Lazztech/TEG/cad/exports/wedge_enclosure.png

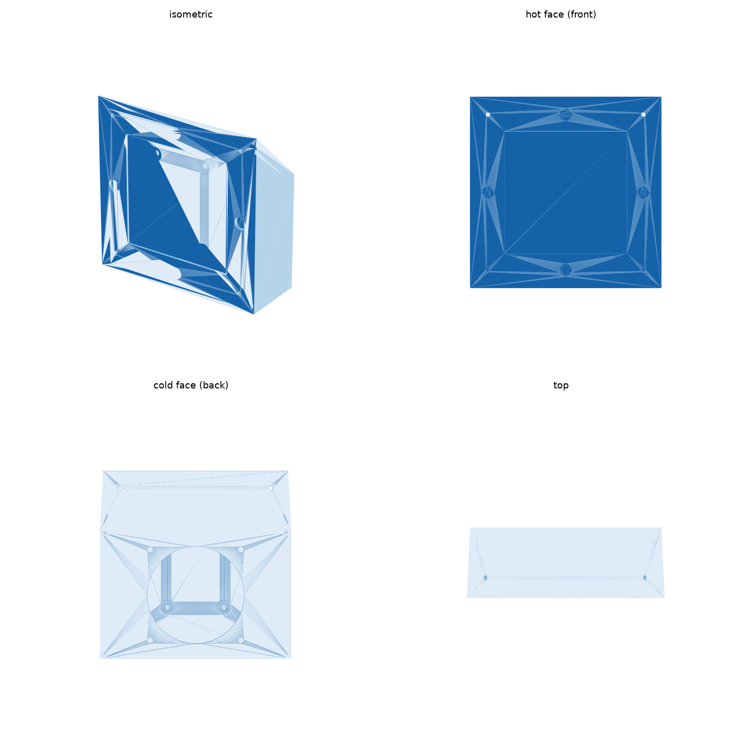
cad/exports/wedge_enclosure.png
