Lazztech/TEG/cad/exports/wedge_enclosure.step

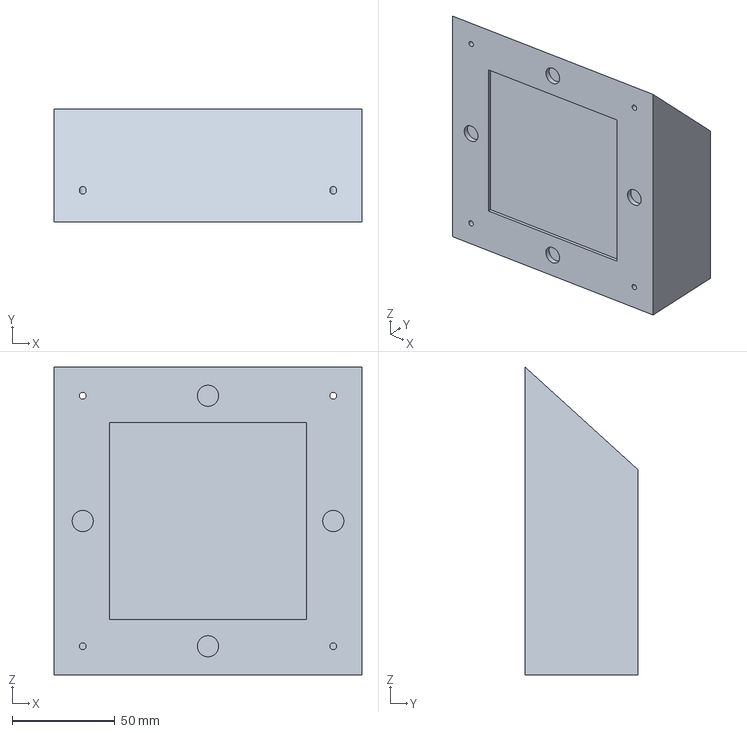
[picture p2: CAD file, 2026-10-20]
cad/exports/wedge_enclosure.step
150.0 x 55.0 x 150.0 mm
