Lazztech/TEG/(list of files, cad)

Other CAD files:
cad/exports/wedge_enclosure.stl
