Lazztech/TEG/hardware/TEG.kicad_pcb

## KiCad design hardware/TEG.kicad_pcb (2026-10-11)

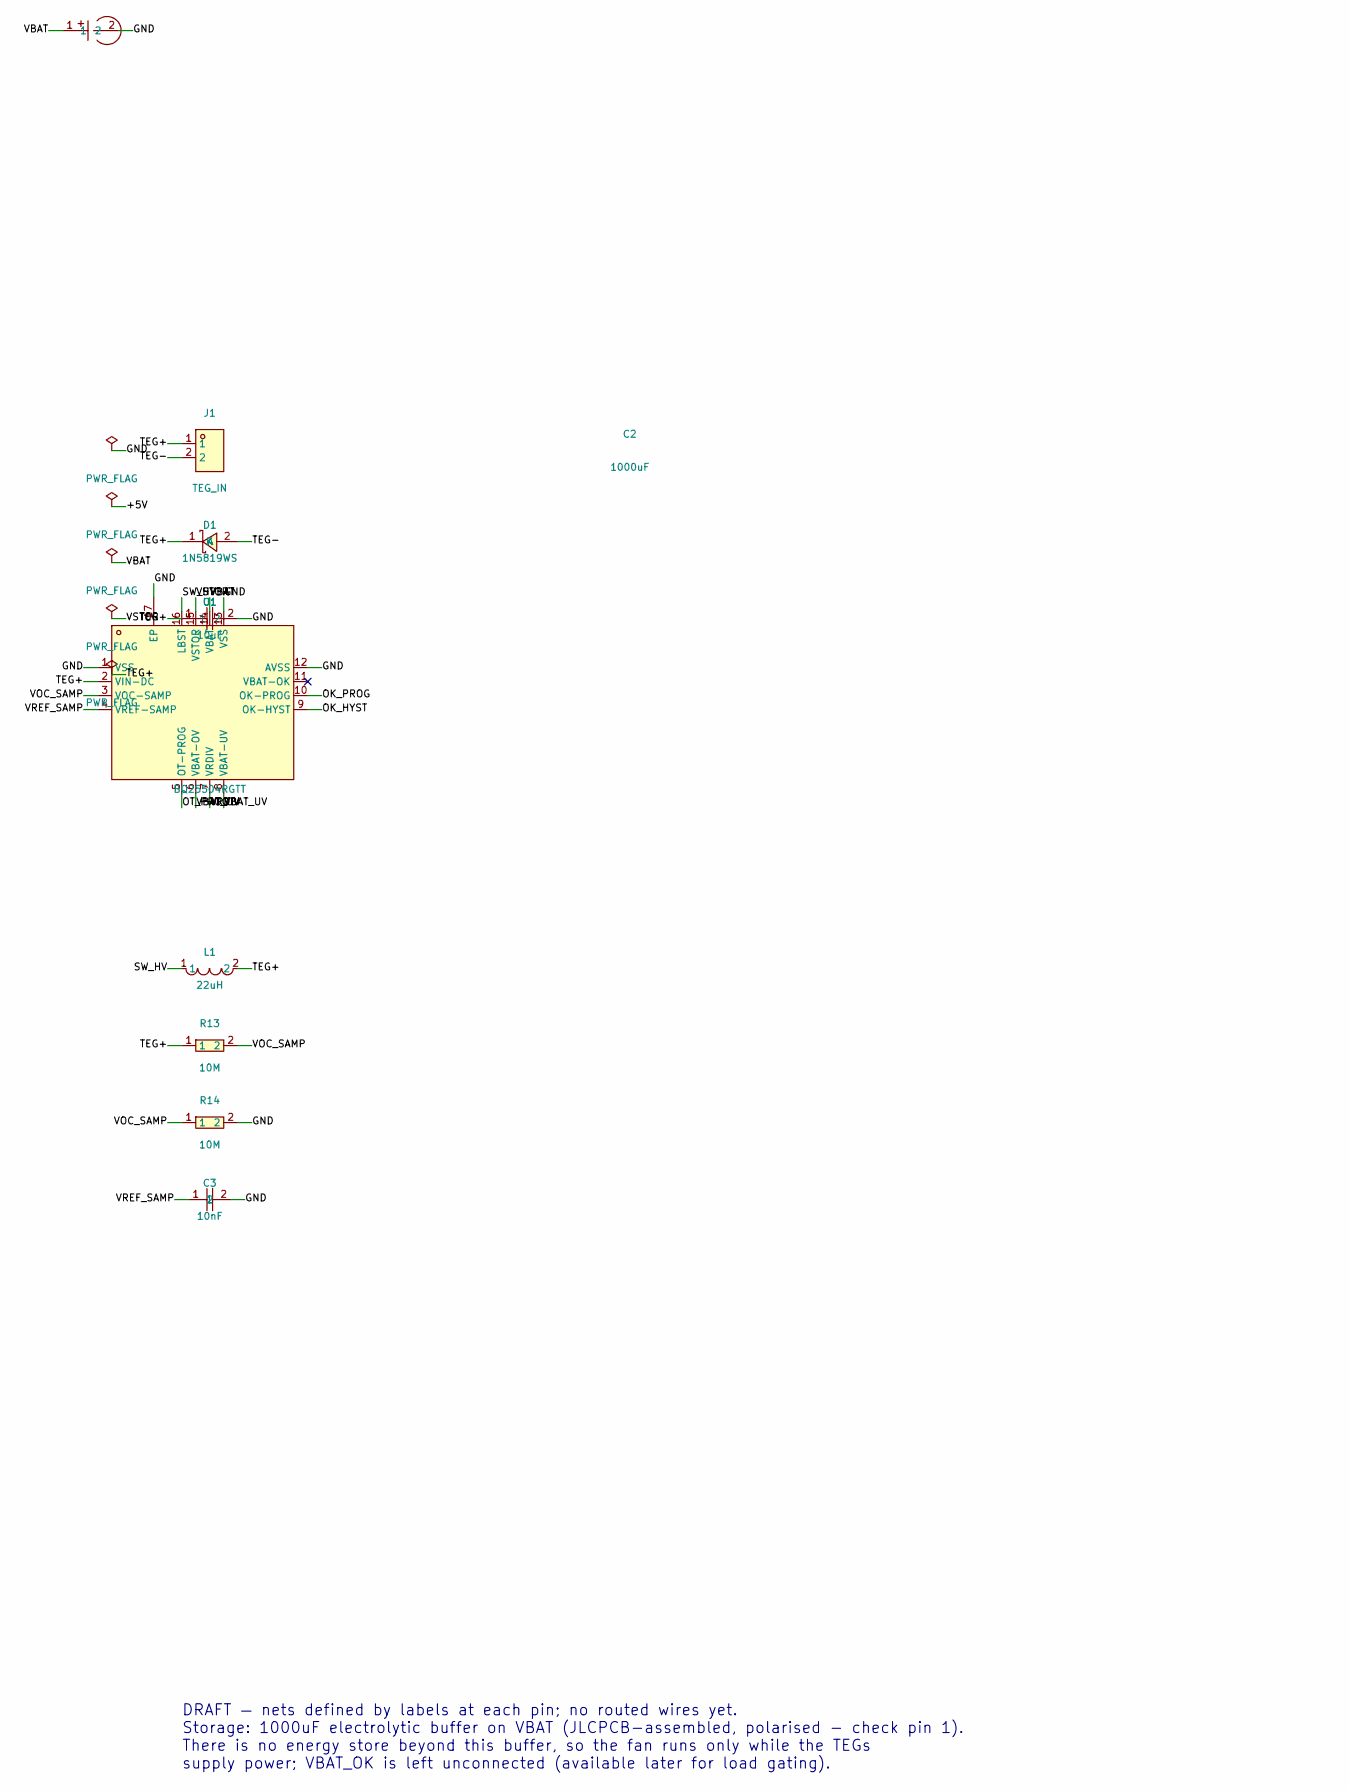
[picture p3: schematic TEG.kicad_sch, TEG Thermal Harvester — Power Conditioning, part in row 1, column 1]

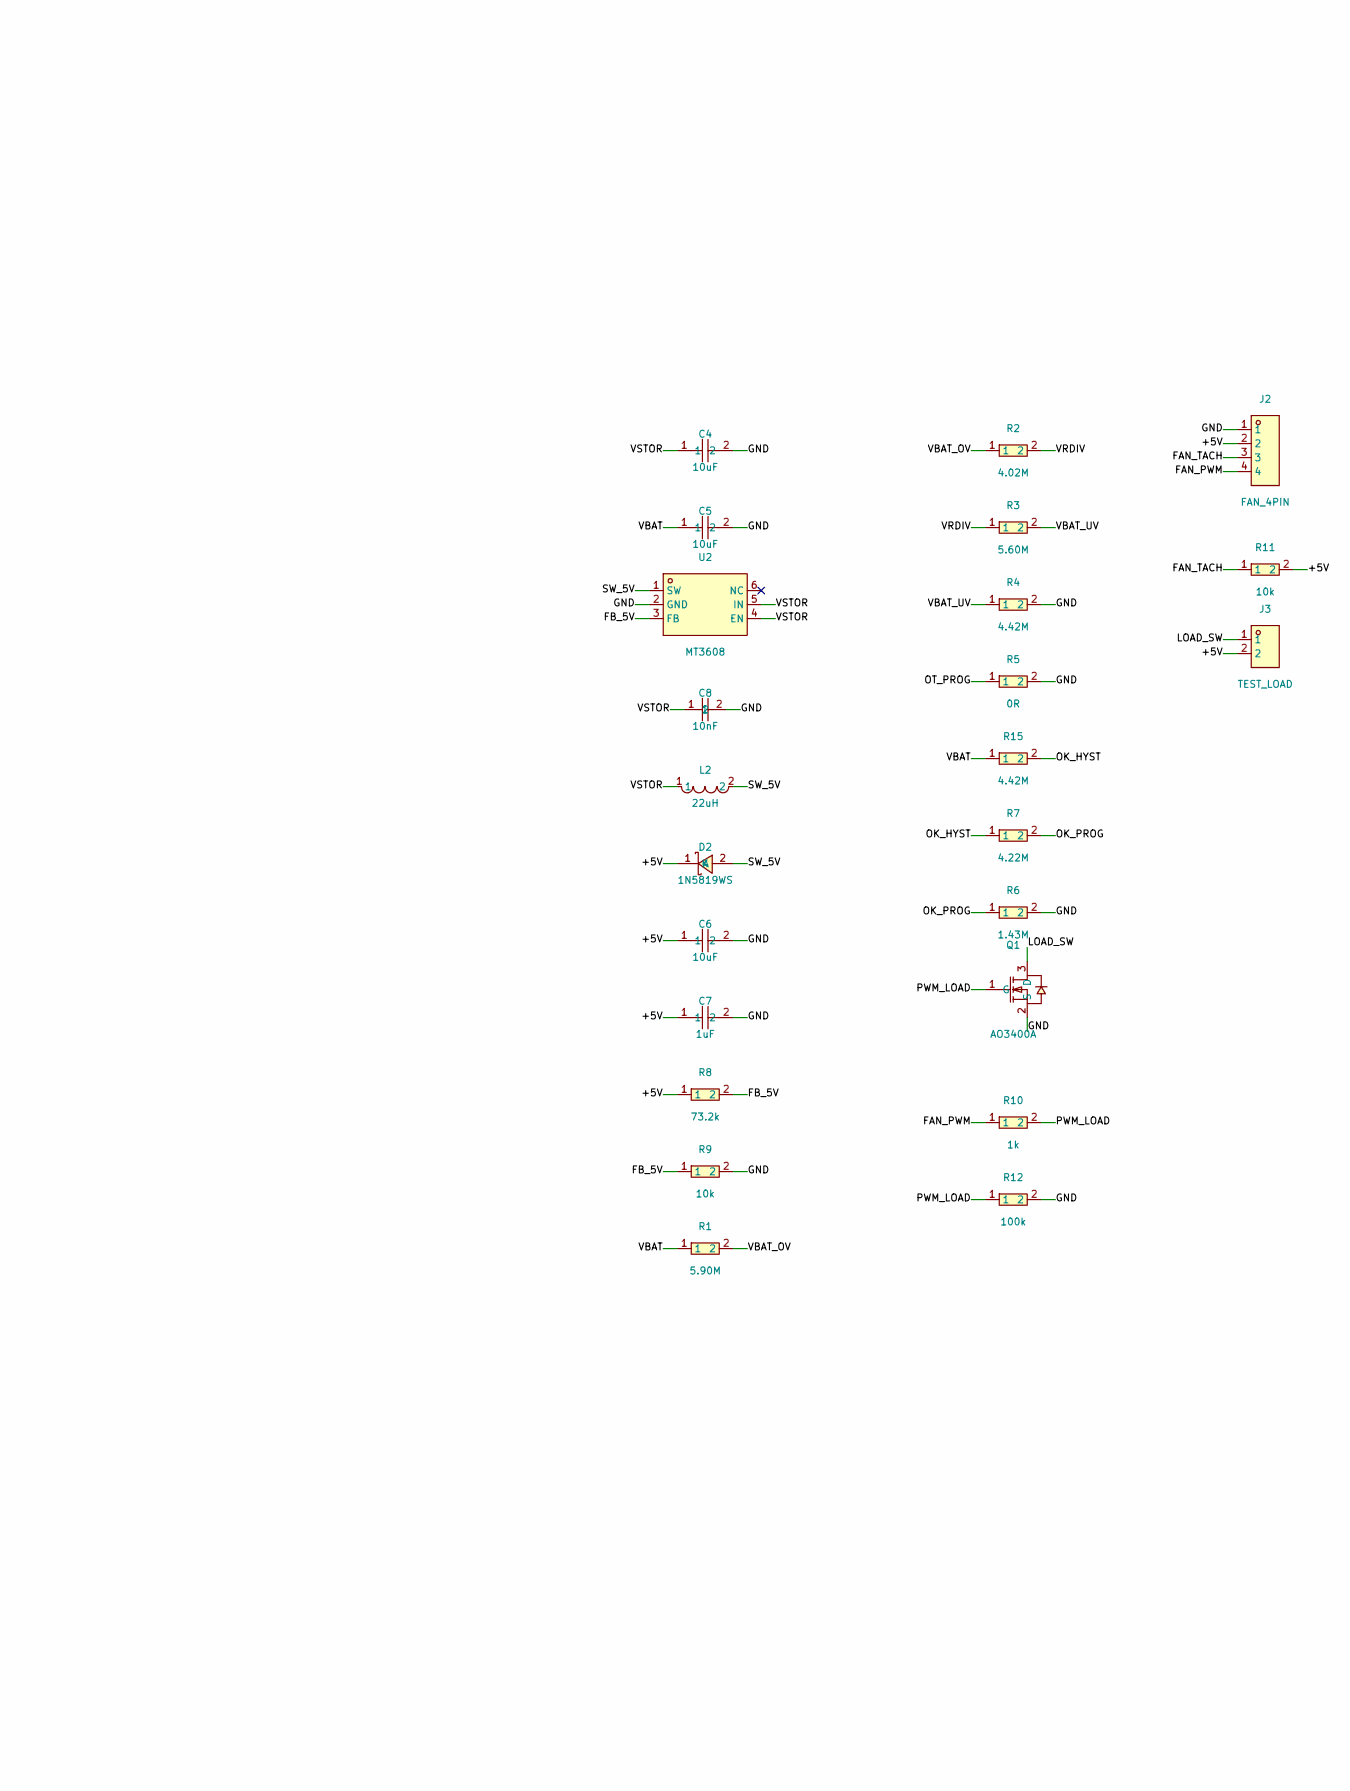
[picture p4: schematic TEG.kicad_sch, TEG Thermal Harvester — Power Conditioning, part in row 1, column 2]

Parts:
C1, C4, C5, C6: 10uF; C0805; LCSC Part C15850
C2: 1000uF; CAP-SMD_BD8.0-L8.3-W8.3-LS9.3-FD-1; LCSC Part C970711
C3, C8: 10nF; C0603; LCSC Part C1589
C7: 1uF; C0603; LCSC Part C15849
D1, D2: 1N5819WS; SOD-323_L1.8-W1.3-LS2.5-RD; LCSC Part C191023
J1: TEG_IN; CONN-TH_P5.08_KF128-5.08-2P; LCSC Part C474952
J2: FAN_4PIN; HDR-TH_4P-P2.54-V-M; LCSC Part C2691448
J3: TEST_LOAD; CONN-TH_P5.08_KF128-5.08-2P; LCSC Part C474952
L1, L2: 22uH; IND-SMD_L4.0-W4.0; LCSC Part C82401
Q1: AO3400A; SOT-23-3_L2.9-W1.3-P1.90-LS2.4-BR; LCSC Part C20917
R1: 5.90M; R0603; LCSC Part C2076902
R2: 4.02M; R0603; LCSC Part C137708
R3: 5.60M; R0603; LCSC Part C23190
R4, R15: 4.42M; R0603; LCSC Part C166806
R5: 0R; R0603; LCSC Part C21189
R6: 1.43M; R0603; LCSC Part C166898
R7: 4.22M; R0603; LCSC Part C166807
R8: 73.2k; R0603; LCSC Part C2933257
R9, R11: 10k; R0603; LCSC Part C25804
R10: 1k; R0603; LCSC Part C21190
R12: 100k; R0603; LCSC Part C25803
R13, R14: 10M; R0603; LCSC Part C114606
U1: BQ25504RGTT; VQFN-16_L3.0-W3.0-P0.50-TL-EP; LCSC Part C157471
U2: MT3608; SOT-23-6_L2.9-W1.6-P0.95-LS2.8-BL; LCSC Part C84817

Connections:
+5V: C6.1, C7.1, D2.1 (K), J2.2, J3.2, R8.1, R11.2
FAN_PWM: J2.4, R10.1
FAN_TACH: J2.3, R11.1
FB_5V: R8.2, R9.1, U2.3 (FB)
GND: C1.2, C2.2, C3.2, C4.2, C5.2, C6.2, C7.2, C8.2, J2.1, Q1.2 (S), R4.2, R5.2, R6.2, R9.2, R12.2, R14.2, U1.1 (VSS), U1.12 (AVSS), U1.13 (VSS), U1.17 (EP), U2.2 (GND)
LOAD_SW: J3.1, Q1.3 (D)
OK_HYST: R7.1, R15.2, U1.9 (OK-HYST)
OK_PROG: R6.1, R7.2, U1.10 (OK-PROG)
OT_PROG: R5.1, U1.5 (OT-PROG)
PWM_LOAD: Q1.1 (G), R10.2, R12.1
SW_5V: D2.2 (A), L2.2, U2.1 (SW)
SW_HV: L1.1, U1.16 (LBST)
TEG+: C1.1, D1.1 (K), J1.1, L1.2, R13.1, U1.2 (VIN-DC)
TEG-: D1.2 (A), J1.2
VBAT: C2.1, C5.1, R1.1, R15.1, U1.14 (VBAT)
VBAT_OV: R1.2, R2.1, U1.6 (VBAT-OV)
VBAT_UV: R3.2, R4.1, U1.8 (VBAT-UV)
VOC_SAMP: R13.2, R14.1, U1.3 (VOC-SAMP)
VRDIV: R2.2, R3.1, U1.7 (VRDIV)
VREF_SAMP: C3.1, U1.4 (VREF-SAMP)
VSTOR: C4.1, C8.1, L2.1, U1.15 (VSTOR), U2.4 (EN), U2.5 (IN)

Notes on the sheet:
DRAFT — nets defined by labels at each pin; no routed wires yet. Storage: 1000uF electrolytic buffer on VBAT (JLCPCB-assembled, polarised - check pin 1). There is no energy store beyond this buffer, so the fan runs only while the TEGs supply power; VBAT_OK is left unconnected (available later for l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

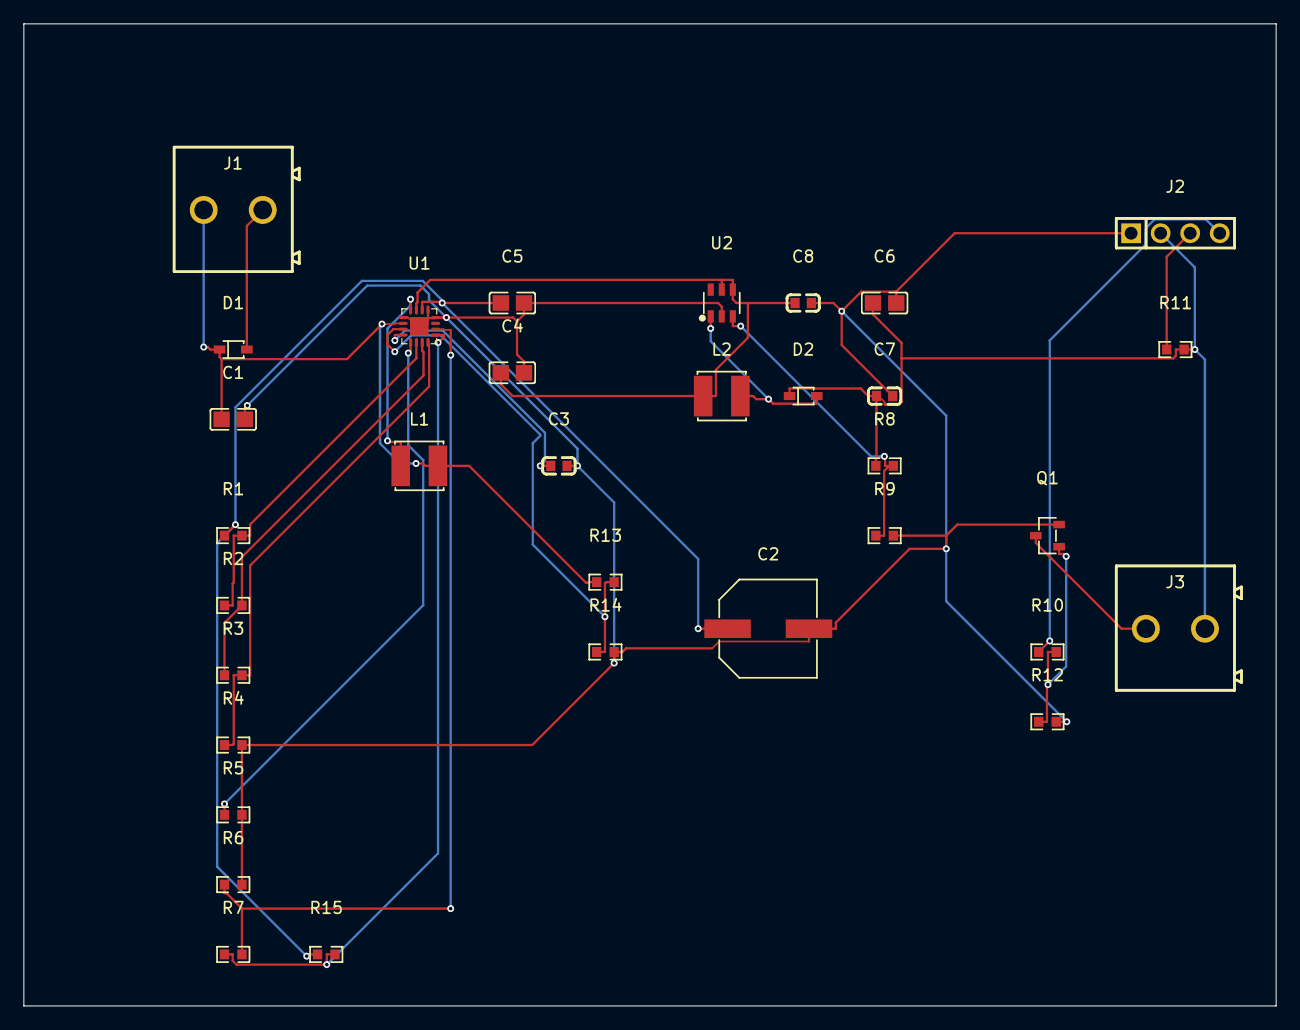
[picture p5: board TEG.kicad_pcb from above]

Board: 2 copper layers, 107.7 x 84.4 mm, 33 parts (0 on the bottom side), 21 nets.
