Lazztech/TEG/(commit log)

2026-10-09 Initial commit: TEG harvester KiCad project (draft, ERC/DRC validated)
    Electronics for a thermal energy harvesting prototype: 2x Marlow
    TG12-4-01LS TEGs in series -> BQ25504 boost charger (MPPT) -> storage
    element (TBD) -> MT3608 5V rail -> Noctua NF-A8 4-pin PWM fan + switched
    0.5 W test load. Target fab: JLCPCB SMT + THT.
    - hardware/: KiCad 10 project; 12 symbols / 10 footprints / 12 WRL 3D
    models fetched from JLCPCB via jlc-client; schematic places all 30
    parts with per-pin net labels; board places all footprints with nets
    assigned (ratsnest only, no copper yet)
    - scripts/: generators for schematic and board from a shared part/net
    table, plus validate.sh (kicad-cli ERC + DRC)
    - E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
    [TEG.kicad_pcb, TEG.kicad_sch]
2026-10-10 Add MPPT sampling network; switch storage to supercapacitor
    The BQ25504 has MPPT built in, but the draft was missing its sampling
    network. Fixed:
    - Add R13/R14 = 10M/10M on VOC_SAMP -> MPP ratio ~50% of Voc
    (TEG matched load; the datasheet's 78% default targets solar)
    - CREF/CBYP = 10nF (C1589); drop the 100nF cap that would have slowed
    the high-impedance sampling node
    - Fix OV/UV chain order to the datasheet topology and add the missing
    third OK-chain resistor (R15); set threshold values from the datasheet
    worked example (VBAT_OV 3.15V / UV 2.20V / OK 2.44V / HYST 2.80V)
    - R5 = 0R ties OT_PROG to GND (65C charge cutoff)
    - L1/L2 corrected to the datasheet-recommended 22uH
    Storage =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
    [TEG.kicad_pcb, TEG.kicad_sch]
2026-10-10 Set R13/R14 to a real 10M 1% part (C114606); record sourcing reality
    Supercaps are not stocked by JLCPCB -> hand-solder. The odd threshold
    resistors are standard E96 values but JLCPCB's public search API was
    degraded and could not resolve them; note that for the buyer.
    [TEG.kicad_sch]
2026-10-10 Document decisions and remaining tasks in README
    - Settled-decisions table (supercap storage, built-in MPPT, 50% ratio,
    3.15 V window, 65C cutoff) with plain-language rationale
    - Remaining-tasks checklist: route copper, source parts, fab export,
    order, bench-verify, then thermal tests
    - Parts-still-to-source table incl. the supercap hand-solder note
    - Power-budget expectation warning for the fan
    - Note the public search API also degrades (verify by LCSC ID instead)
    Also drop a duplicate PWR_FLAG entry from the symbol library and sync
    PLAN next steps + changelog.
    [TEG.kicad_sch]
2026-10-11 Source every part from the JLCPCB catalogue; document the storage decision
    jlc-client's search index degraded to returning the same high-stock list
    for every query, so add scripts/jlc_lookup.py which queries JLCPCB's own
    parts API and reports id + library type + stock.
    All 31 machine-placed parts now verified in the catalogue:
    - 22uH inductor -> C82401 (SWPA4020S220MT, 4x4mm, 1.05A)
    - odd E96 threshold resistors -> C2076902/C137708/C23190/C166806/
    C166807/C166898 (all in stock)
    - MT3608 divider computed: 73.2k/10k -> 5.0V (C2933257/C25804)
    - R10 -> 1k base part C21190
    Flag: BQ25504RGTT (C157471) is low stock (7); C2876746 is the same part.
    Confirmed via JLCPCB's API that supercapacitors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
    [TEG.kicad_pcb, TEG.kicad_sch]
2026-10-11 Storage: option D electrolytic buffer (100% JLCPCB assembled)
    The user chose the fully-automated path: no supercap, no battery. Adds
    C2 = 1000uF 6.3V SMD electrolytic (C970711) as the VBAT buffer, which is
    what the BQ25504 needs to operate (datasheet reference shows >100uF).
    Consequences documented rather than glossed over: with ~5mJ stored (vs
    ~1.2J for a supercap) the fan can only run on live harvest, not from
    storage. VBAT_OK is left unconnected with a no-connect marker; the
    datasheet confirms it is a low-drive digital output referenced to VSTOR,
    so gating the load would need extra parts - deferred.
    Also: pin-type normalisation now never clobbers power pins (a previous
    pass had turned P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
    [TEG.kicad_pcb, TEG.kicad_sch]
2026-10-11 README: rewrite for the option-D storage decision and current state
    The README still described the storage element as an open question with
    four options; option D was chosen and implemented. Rewrite it to match:
    storage settled, parts all JLCPCB-verified, routing as the one remaining
    design step with a concrete order, and the option-D consequences stated
    (fan runs only on live harvest).
2026-10-11 Attempt scripted routing; document why it was abandoned
    Wrote scripts/route_board.py - a 2-layer maze (Lee) router with rectangular
    pad obstacles, per-pad fanout escapes (needed: a 0.3mm track cannot escape
    0.5mm pitch, and neighbours' clearance margins otherwise wall in every
    VQFN pin), vias, and net ordering. Iterated against kicad-cli DRC.
    Found and fixed four real bugs on the way: the occupancy map was
    initialised to its own 'blocked' sentinel so nothing ever blocked;
    unconnected pads were not obstacles; SMD terminals could finish on the
    wrong layer; and the track was too thick for fine-pitch fanout.
    Outcome: ~95% of connections routed but never DRC-clean. A halo tight
    enough to route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
2026-10-11 Route the board with FreeRouting: DRC-clean, fab outputs generated
    KiCad has no autorouter, so this uses the standard SPECCTRA round-trip,
    scripted in scripts/freeroute.sh:
    pcbnew ExportSpecctraDSN -> freerouting -de/-do -> ImportSpecctraSES -> DRC
    FreeRouting reported 0 unrouted and 0 violations on both the routing and
    optimisation passes, and KiCad's DRC agrees: 0 violations, 0 unconnected
    items. It does the rip-up-and-retry the hand-written route_board.py
    lacked.
    Details:
    - Net classes (Default, Power) are defined in gen_board.py and exported
    into the DSN so the router obeys them. Widths are 0.2mm for both: the
    power/GND nets also land on U1's 0.5mm-pitch pins where a wider track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
    [TEG.kicad_pcb]
2026-10-11 Add 3D render script and refresh docs
    scripts/render.sh renders top / isometric / bottom views plus a close-up of
    the harvester section (BQ25504 + MPPT divider + inductors) via
    kicad-cli pcb render. Outputs go to build/render/ (gitignored).
    Also fetched the two 3D models that were missing for the newer footprints
    (the 4x4mm inductor and the 8mm electrolytic) and named them as the
    footprints reference them, so every part now renders.
    KiCad's 3D view shows the board, silkscreen and component bodies but not
    the copper traces - noted in the README; the routed 2D PDF shows those.
2026-10-11 Document connectors and TEG series wiring in the README
    Adds the physical interface the README was missing: J1/J2/J3 pinouts, how to
    wire two TEGs in series across the 2-position input terminal, the plain-
    English note that series doubles voltage, and the fan wiring (PWM needs an
    external source as there is no MCU; TACH has a pull-up).
    Also records the limitation that a 2-position J1 cannot measure the modules
    independently, and that a 3-position terminal (KF128-5.08-3P, C474953) would
    fix that - not changed, pending a decision.
2026-10-11 Add whole-device REQUIREMENTS.md; re-scope to a ~3-4 W design
    The requirements document covers the full device, not just the electronics:
    purpose, electrical (E1-E6), physical (P1-P5), thermal and safety
    (T1-T5, S1-S4), manufacturing (M1-M6) and verification (V1-V6), plus a
    system BOM split into 'ordered from JLCPCB' vs 'buy separately'.
    Settled targets: ~3-4 W, 5 V, 1x USB-A + 1x USB-C sharing the output,
    fan-cooled (no water), wedge with magnets on a fireplace, <= 00 BOM,
    inside a 180x180x180 mm Bambu A1 mini envelope.
    Corrects an earlier error in this project's analysis: the initial 5-10 W
    verdict assumed a passive heatsink at dT ~50C. With fan-forced cooling at
    dT ~70C, per-module outp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
2026-10-11 Record v2 power-path design decisions; pick USB output parts
    Unblocked-by-datasheet parts of the redesign, all verified in the JLCPCB
    catalogue:
    - Buck front end TPS54331DR (C9865): 3 A, up to 28 V in, SOIC-8
    - USB-C receptacle TYPE-C-31-M-12 (C165948); SMD USB-A AF 10.0
    QT-ZB6.8 (C456016)
    - USB-C as a source: 56k Rp on CC1/CC2 advertises 500 mA per port, the
    honest figure for a 3-4 W shared output (C23206, a BASIC part)
    - USB-A as a DCP charging port: D+/D- shorted, no IC
    - MPPT approach: a constant-power load drags a resistive source to
    ~V_oc/2, so a buck with input UVLO approximates MPPT; explicit
    fractional-V_oc regulation only if measurement justifies it
    - Fan driver reuses AO34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
2026-10-11 Obtain and extract the TEG module datasheet; verify the power target
    Closes the datasheet-verification item that has been open since day one.
    Sourced via alldatasheet -> Bing -> Coherent's own PDF, since the direct
    search engines and the datasheet aggregator are blocked from this
    environment.
    Verified for the Coherent/Marlow TG12-4:
    - 200 C continuous rating (230 C intermittent hot side)
    - AC resistance 2.76-3.41 ohm, ZT 0.71, thermal resistance ~2.2 C/W
    - Clamp at 1.4 MPa (200 psi) with thermal grease or graphite pads
    - Cold side 50 C performance:
    hot 230 C -> 4.05 W, 5.26 V, Voc 9.45 V, 4.97% efficient
    hot 170 C -> 2.12 W, 3.66 V, Voc 6.50 V
    hot 110 C -> 0.61 W, 1.86 V, Voc 3.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
2026-10-11 Record USB-C PD survey and fallback for the both-roles requirement
    USB role is both bank charging and powering loads, so USB-C PD is in scope.
    JLCPCB survey: CH224A/D and HUSB601/HUSB237 are SINK controllers (wrong
    direction); SW3518S (C406811) is a source IC but has 0 stock. Best
    candidate is IP6518 (C181688, QFN-24-EP, 9117 stock), still needing a
    datasheet check to confirm it is a source/DFP controller.
    Fallback: a 5 V source with Rp advertising (22k = 1.5 A, C31850, a BASIC
    part), which charges most banks and powers loads; PD only matters for banks
    that refuse non-PD sources.
2026-10-15 Script the JLCPCB fab package; document the approval-gated ordering flow
    One command (scripts/fab_export.sh) produces Gerbers + Excellon drill + JLCPCB
    BOM + CPL and a gerber zip for upload. scripts/jlc_bom.py reads the schematic's
    LCSC Part properties; scripts/jlc_cpl.py converts the KiCad pos file to JLCPCB's
    CPL columns. Default is SMT-only assembly with the BOM restricted to the CPL
    designators so the two agree; --tht includes through-hole parts.
    Ordering stays manual and approval-gated: JLCPCB's official Open Platform API is
    application-gated and not wired. Full flow in docs/jlcpcb-fabrication.md.
2026-10-15 Add a code-CAD toolchain (build123d) for the wedge enclosure
    Agents can now author and edit the printed wedge enclosure as code and export
    STEP + printable STL end to end, with no human relaying.
    - cad/parameters.py every dimension (single source of truth)
    - cad/wedge.py parameterised wedge; exports STEP/STL + a 4-view preview
    - scripts/cad-setup.sh sudo-free bootstrap of the repo-local .venv toolchain
    - scripts/cad-run.sh run the model with the right env
    - docs/cad-toolchain.md tool decision, layout, conventions, requirements map
    - cad/exports/ committed STEP + STL (input to the Bambu print task)
    Model satisfies P1 (150x55x150 mm on the 180^3 A1 mini bed), P2 (wedge),
    T2/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
    [wedge_enclosure.step, wedge_enclosure.stl]
2026-10-15 Bake off the wedge enclosure across build123d, CadQuery and SolidCraft
    Author the same enclosure (same cad/parameters.py) with two more
    agent-drivable tools so the result can be judged by review and print quality,
    not by description.
    - cad/bakeoff/cadquery/wedge_cq.py CadQuery port (same OCCT kernel)
    - cad/bakeoff/solidcraft/wedge.json SolidCraft command script (truck kernel)
    - cad/bakeoff/*/exports/ committed STEP + STL + preview per tool
    - scripts/cad-setup-cadquery.sh, cad-run-cadquery.sh .venv-cadquery toolchain
    - scripts/cad-solidcraft.sh pins + downloads the SolidCraft CLI
    - cad/bakeoff/README.md comparison, how to run, print guidance
    - cad/bakeo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
    [wedge_enclosure.step, wedge_enclosure.stl]
2026-10-16 Add FreeCAD as contender #4 in the CAD bake-off
    The user asked to also consider FreeCAD. Author the same wedge enclosure with
    FreeCAD's Part scripting API (headless freecadcmd) and add it to the bake-off.
    - cad/bakeoff/freecad/wedge_fc.py FreeCAD port (same OCCT kernel)
    - cad/bakeoff/freecad/exports/ committed STEP + STL + preview
    - scripts/cad-run-freecad.sh pins + downloads the FreeCAD AppImage
    - cad/bakeoff/freecad/README.md gotchas (makeThickness, freecadcmd argv,
    binary STL via MeshPart)
    - cad/bakeoff/README.md, docs/cad-toolchain.md updated for four tools
    FreeCAD matches the other three exactly: 150x55x150 mm, 248.4 cm^3 (build123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
    [wedge_enclosure.step, wedge_enclosure.stl]
2026-10-20 Add CI validation for CAD artifacts and engineering outputs
    - scripts/validate_cad.py checks committed STEP/STL artifacts: manifold and
    single-body meshes, bed fit, STEP<->STL agreement, bake-off agreement, and
    a stale-export rebuild of cad/wedge.py.
    - scripts/validate.sh is the single entry point (--cad / --hardware) and now
    gates on KiCad error-level violations while reporting warnings.
    - .github/workflows/validate.yml runs the CAD, hardware (ERC/DRC + JLCPCB
    package) and script-syntax jobs and uploads the reports.
    - docs/validation.md documents what runs, local usage, failure fixes, scope.
2026-10-20 Fix JLCPCB package glob for KiCad gerber filenames
2026-10-20 Add a lint/test gate and live-viewer workflow for the code-CAD models
2026-10-20 Trim the CAD PR to the build123d toolchain we will maintain
    [wedge_enclosure.step, wedge_enclosure.stl]
